iCarlyFan392/5stageOscilator-FirstEverTrip/top_schematic.png

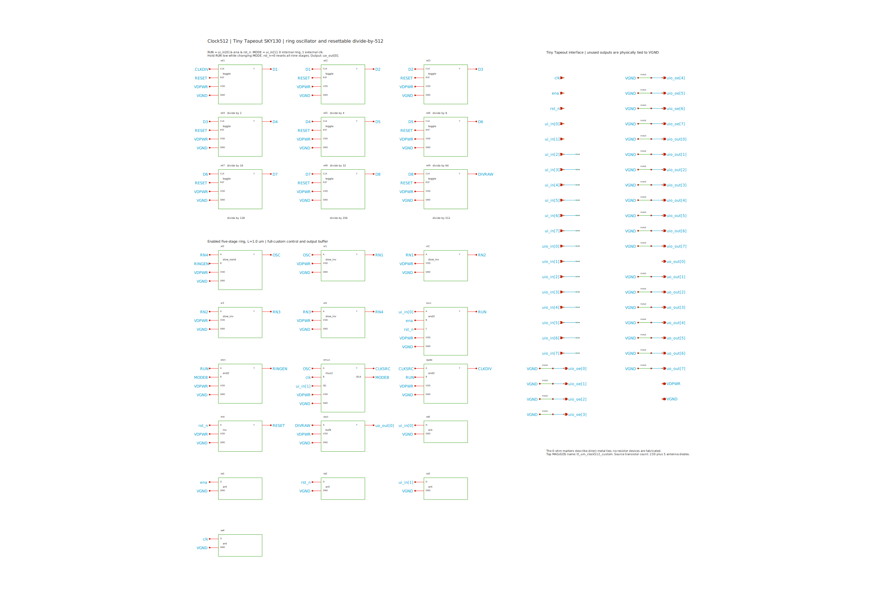
top_schematic.png
