iCarlyFan392/5stageOscilator-FirstEverTrip/project.v

// SPDX-License-Identifier: Apache-2.0
// Physical black-box interface. Transistor implementation is in schematic/ and layout/.
`default_nettype none
module tt_um_clock512_custom (
    input wire VGND,
    input wire VDPWR,
    input wire [7:0] ui_in,
    output wire [7:0] uo_out,
    input wire [7:0] uio_in,
    output wire [7:0] uio_out,
    output wire [7:0] uio_oe,
    input wire ena,
    input wire clk,
    input wire rst_n
);
endmodule
`default_nettype wire
